arkhipus/u1-heater/3dprint/heater_complete.step

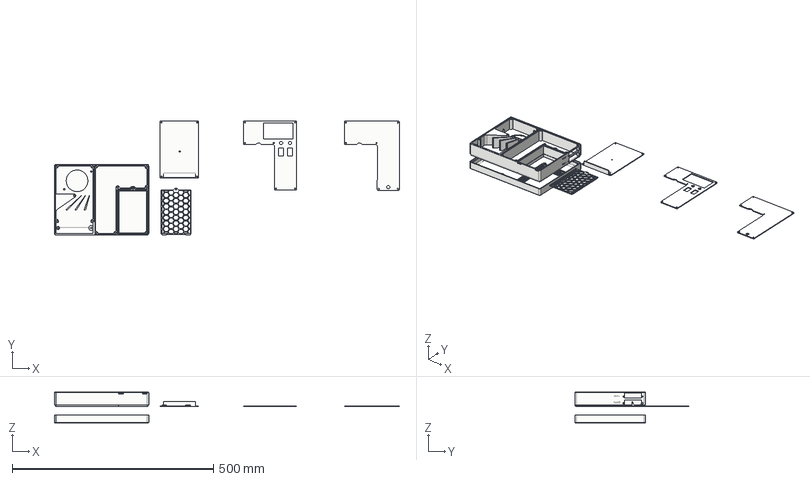
[picture p1: CAD file, 2026-10-26]
3dprint/heater_complete.step
856.5 x 284.0 x 76.0 mm
