arkhipus/u1-heater/3dprint/control_box.step

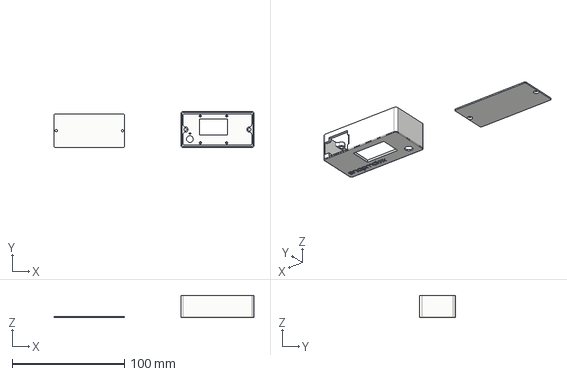
[picture p2: CAD file, 2026-11-09]
3dprint/control_box.step
177.8 x 32.0 x 20.0 mm
