arkhipus/u1-heater/3dprint/window_intake.step

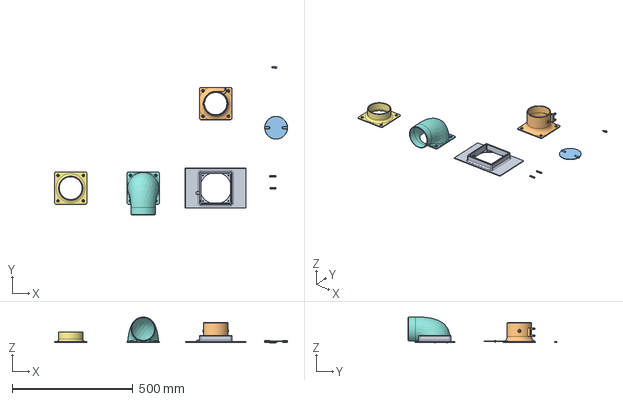
[picture p3: CAD file, 2026-11-09]
3dprint/window_intake.step
964.1 x 614.5 x 107.5 mm
