arkhipus/u1-heater/3dprint/mb_fan_bracket.step

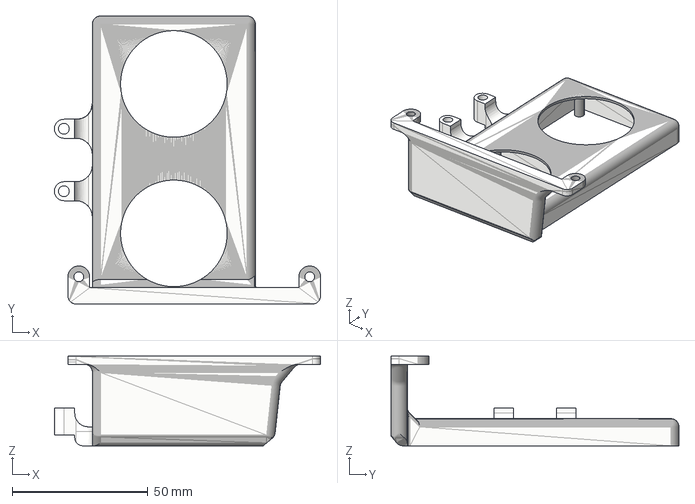
[picture p4: CAD file, 2026-10-28]
3dprint/mb_fan_bracket.step
98.0 x 106.0 x 33.0 mm
