arkhipus/u1-heater/3dprint/kds301_bracket.step

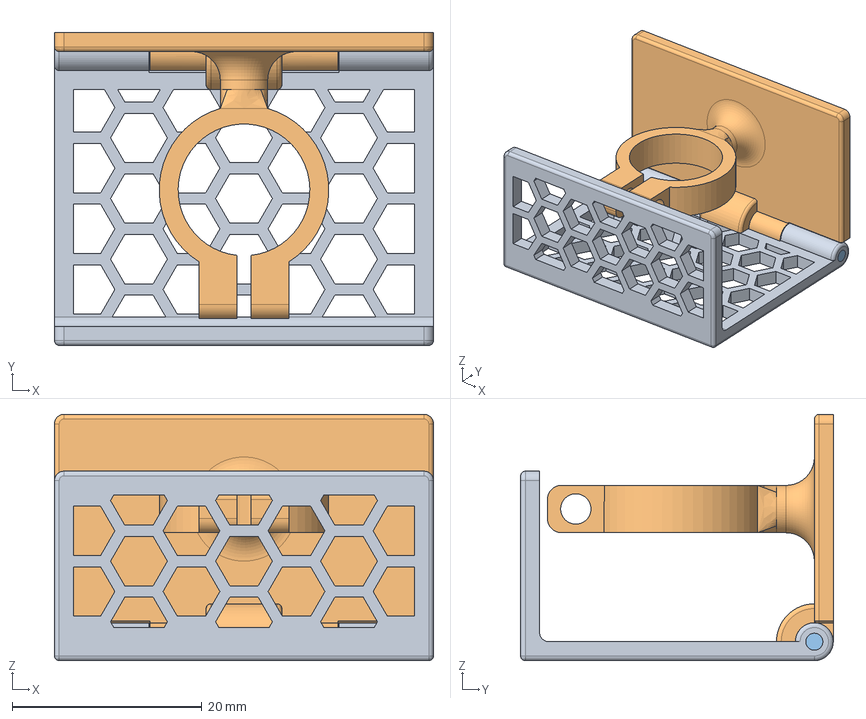
[picture p5: CAD file, 2026-10-28]
3dprint/kds301_bracket.step
40.0 x 33.0 x 26.0 mm
