arkhipus/u1-heater/(list of files, cad)

Other CAD files:
3dprint/control_box.f3d
3dprint/heater_complete.f3d
3dprint/kds301_bracket.f3d
3dprint/mb_fan_bracket.f3d
3dprint/window_intake.f3d
