arkhipus/u1-heater/docs/chamber_controller_schematic.pdf

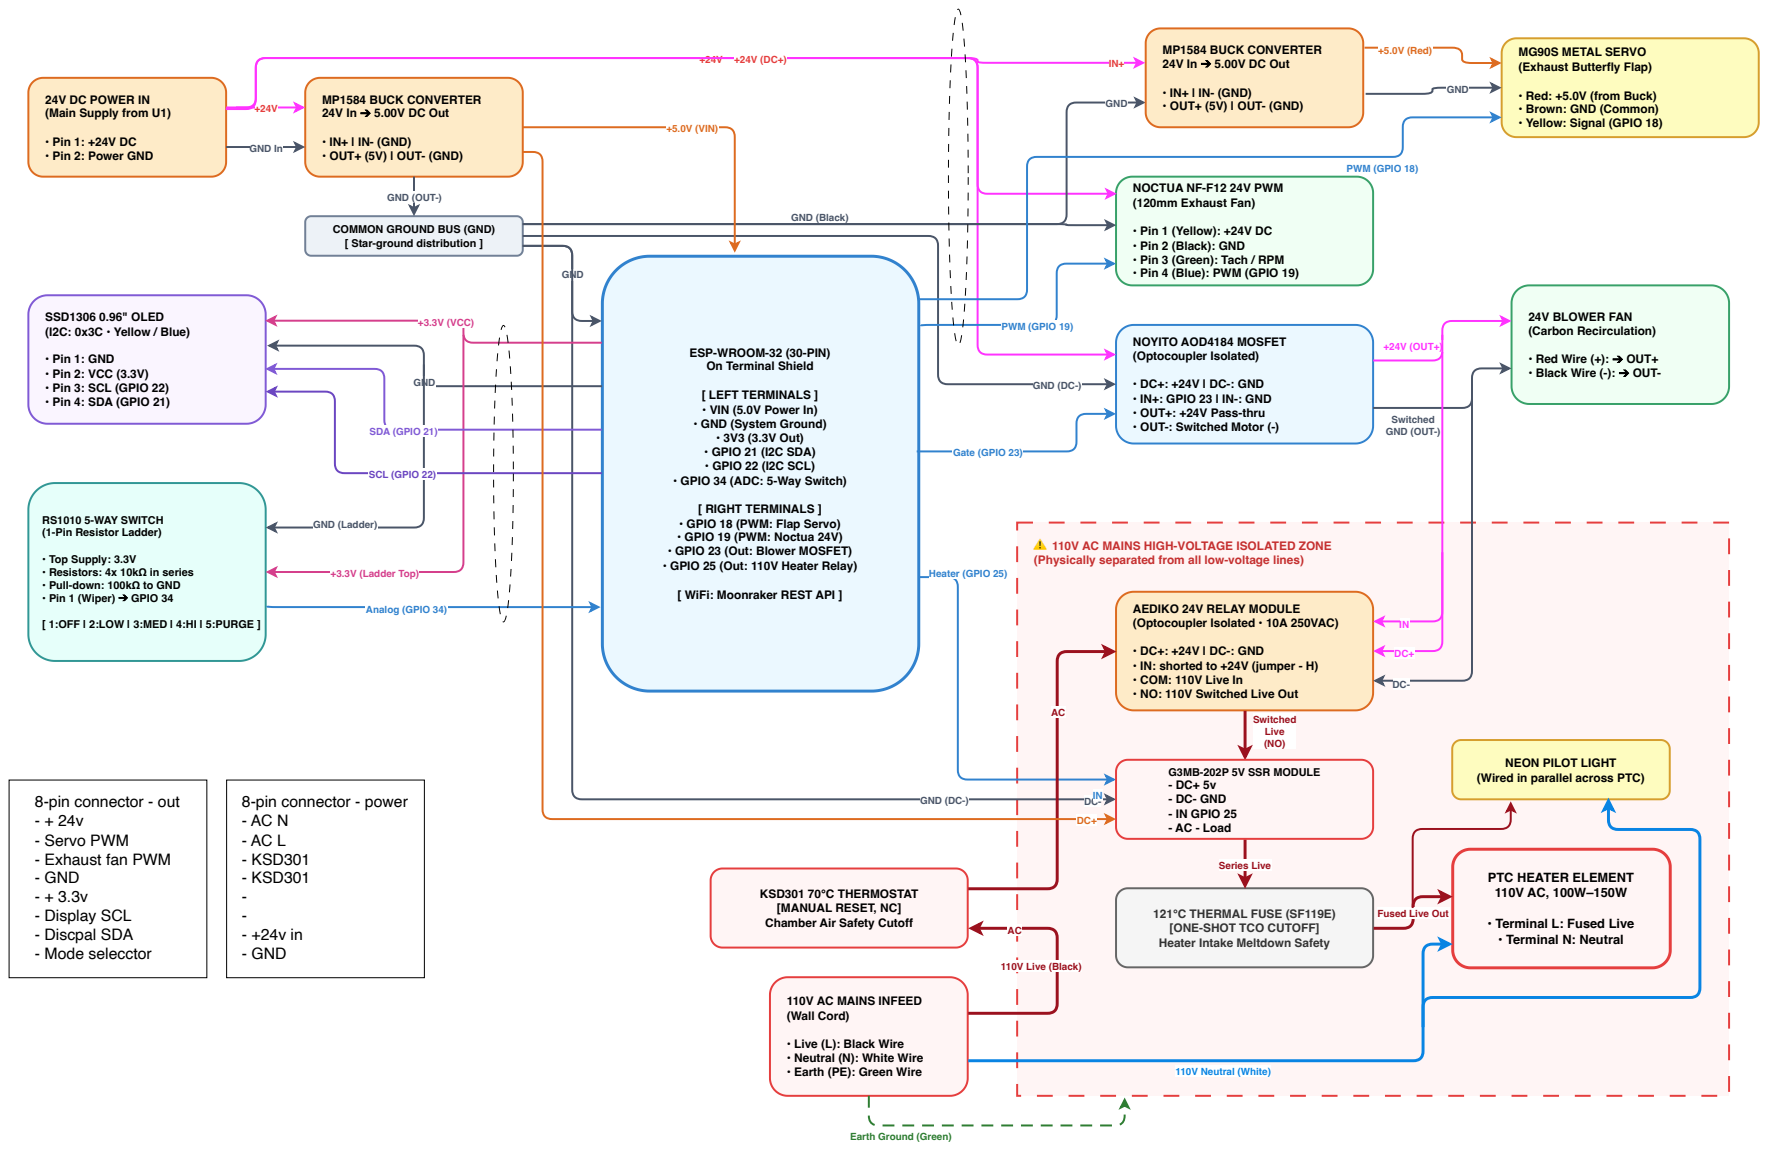
[picture p6: page 1]
SSD1306 0.96" OLED (I2C: 0x3C • Yellow / Blue); NOYITO AOD4184 MOSFET (Optocoupler Isolated); 24V BLOWER FAN (Carbon Recirculation); Chamber Air Safety Cutoff; 121°C THERMAL FUSE (SF119E); +24V (OUT+); GND In; GND (OUT-); GND; GND (Black); GND (DC-); GND (Ladder); +5.0V (VIN); +5.0V (Red); +3.3V (VCC); +3.3V (Ladder Top); SDA (GPIO 21); SCL (GPIO 22); Analog (GPIO 34); PWM (GPIO 18); PWM (GPIO 19); Gate (GPIO 23); Heater (GPIO 25); Switched GND (OUT-); 110V Live (Black); Switched Live (NO)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

MP1584 BUCK CONVERTER
24V In ➔ 5.00V DC Out

MG90S METAL SERVO
(Exhaust Butterfly Flap)

24V DC POWER IN
(Main Supply from U1)

• IN+ | IN- (GND)
• OUT+ (5V) | OUT- (GND)

• Red: +5.0V (from Buck)
• Brown: GND (Common)
• Yellow: Signal (GPIO 18)

• Pin 1: +24V DC
• Pin 2: Power GND

NOCTUA NF-F12 24V PWM
(120mm Exhaust Fan)

COMMON GROUND BUS (GND)
[ Star-ground distribution ]

• Pin 1 (Yellow): +24V DC
• Pin 2 (Black): GND
• Pin 3 (Green): Tach / RPM
• Pin 4 (Blue): PWM (GPIO 19)

ESP-WROOM-32 (30-PIN)
On Terminal Shield

• Pin 1: GND
• Pin 2: VCC (3.3V)
• Pin 3: SCL (GPIO 22)
• Pin 4: SDA (GPIO 21)

• Red Wire (+): ➔ OUT+
• Black Wire (-): ➔ OUT-

• DC+: +24V | DC-: GND
• IN+: GPIO 23 | IN-: GND
• OUT+: +24V Pass-thru
• OUT-: Switched Motor (-)

[ LEFT TERMINALS ]
• VIN (5.0V Power In)
• GND (System Ground)
• 3V3 (3.3V Out)
• GPIO 21 (I2C SDA)
• GPIO 22 (I2C SCL)
• GPIO 34 (ADC: 5-Way Switch)

[ RIGHT TERMINALS ]
• GPIO 18 (PWM: Flap Servo)
• GPIO 19 (PWM: Noctua 24V)
• GPIO 23 (Out: Blower MOSFET)
• GPIO 25 (Out: 110V Heater Relay)

RS1010 5-WAY SWITCH
(1-Pin Resistor Ladder)

⚠️ 110V AC MAINS HIGH-VOLTAGE ISOLATED ZONE
(Physically separated from all low-voltage lines)

• Top Supply: 3.3V
• Resistors: 4x 10kΩ in series
• Pull-down: 100kΩ to GND
• Pin 1 (Wiper) ➔ GPIO 34

[ WiFi: Moonraker REST API ]

AEDIKO 24V RELAY MODULE
(Optocoupler Isolated • 10A 250VAC)

[ 1:OFF | 2:LOW | 3:MED | 4:HI | 5:PURGE ]

• IN: shorted to +24V (jumper - H)
• COM: 110V Live In
• NO: 110V Switched Live Out

NEON PILOT LIGHT
(Wired in parallel across PTC)

8-pin connector - out
- Servo PWM
- Exhaust fan PWM
- GND
- Display SCL
- Discpal SDA
- Mode selecctor

PTC HEATER ELEMENT

KSD301 70°C THERMOSTAT
[MANUAL RESET, NC]

Fused Live Out

• Terminal L: Fused Live
• Terminal N: Neutral

[ONE-SHOT TCO CUTOFF]
Heater Intake Meltdown Safety

110V AC MAINS INFEED
(Wall Cord)

• Live (L): Black Wire
• Neutral (N): White Wire
• Earth (PE): Green Wire

Earth Ground (Green)
