arkhipus/u1-heater/arduino/esp32_heater.cpp/secrets.sample.h

// --- Configuration ---
const char* WIFI_SSID     = "Your Wi-Fi SSID"; // Update with your SSID
const char* WIFI_PASSWORD = "Password 123"; // Your Wi Fi password
const char* U1_IP_ADDRESS = "192.168.1.101"; // Set IP of your U1 as static on the router
