arkhipus/u1-heater/(commit log)

2026-10-26 added 3d print files
    [heater_complete.f3d, heater_complete.step]
2026-10-27 updated schematic, added diagram in pdf
2026-10-28 added aux 3d models
    [control_box.f3d, control_box.step, kds301_bracket.f3d, kds301_bracket.step, mb_fan_bracket.f3d, mb_fan_bracket.step, window_intake.f3d, window_intake.step]
2026-10-28 updated schematics pdf
2026-10-29 added support for u1 top connector
2026-11-09 add a bunch of 3d prints
    [control_box.step, window_intake.step]
